Azdle/Tuner/README.markdown

#Freq Tuner
This repo contains some of the source and docs for a frequency tuner project for EE3102.

##Folders
* Prelim Report - Document files for the ungraded preliminary design report.

##TODO
* Setup Others

##Group Members
* Prashant
* Mark Pennebecker
