Azdle/Tuner/Design Report/Analog Subcircuit.pdf

Pre-Amp | Filter | Square Wave Generator
Signal | Microcontroller
