Azdle/Tuner/Design Report/Block Overview.pdf

Analog
Subcircuit | Microcontroller | LED Display Signal
