Azdle/Tuner/Prelim Report/Block Overview.pdf

Pre-Amp | Audio-Range
Filter | Square Wave | Output Buffer
