Azdle/Tuner/pic_code/PIC configuration layout.png

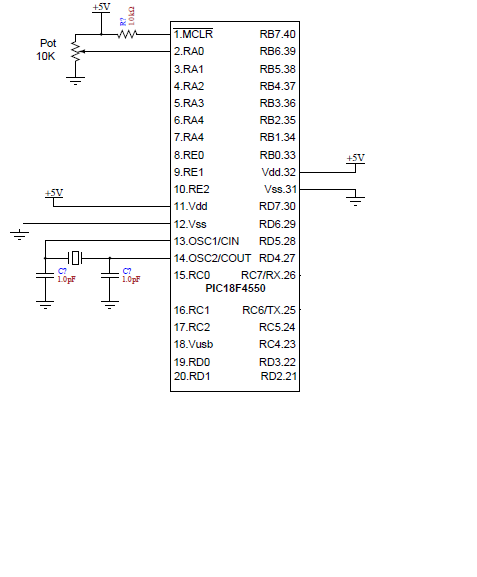
pic_code/PIC configuration layout.png
