Azdle/Tuner/Design Report/filter take 2-SCHEMATIC1-AC.pdf

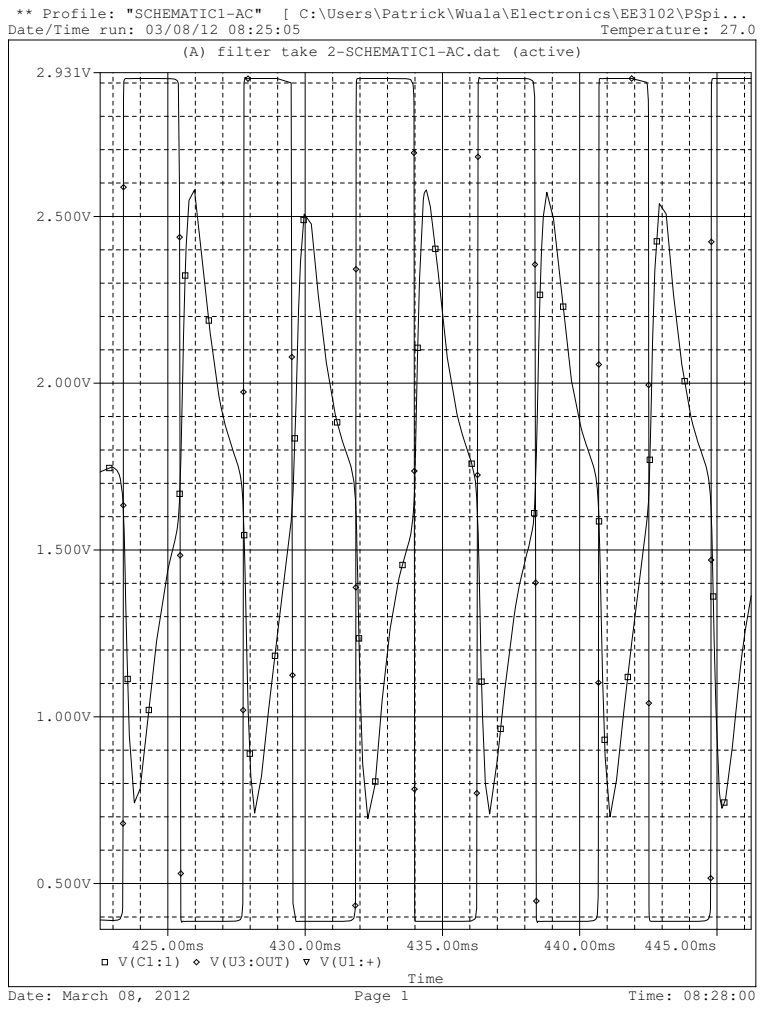
[picture p11: page 1]
** Profile: "SCHEMATIC1-AC"; [ C:\Users\Patrick\Wuala\Electronics\EE3102\PSpi...; Temperature: 27.0; Date: March 08, 2012; Page 1; Time: 08:28:00; Time; V(U3:OUT)

Date/Time run: 03/08/12 08:25:05

(A) filter take 2-SCHEMATIC1-AC.dat (active)
