Azdle/Tuner/Analog Proposal.pdf

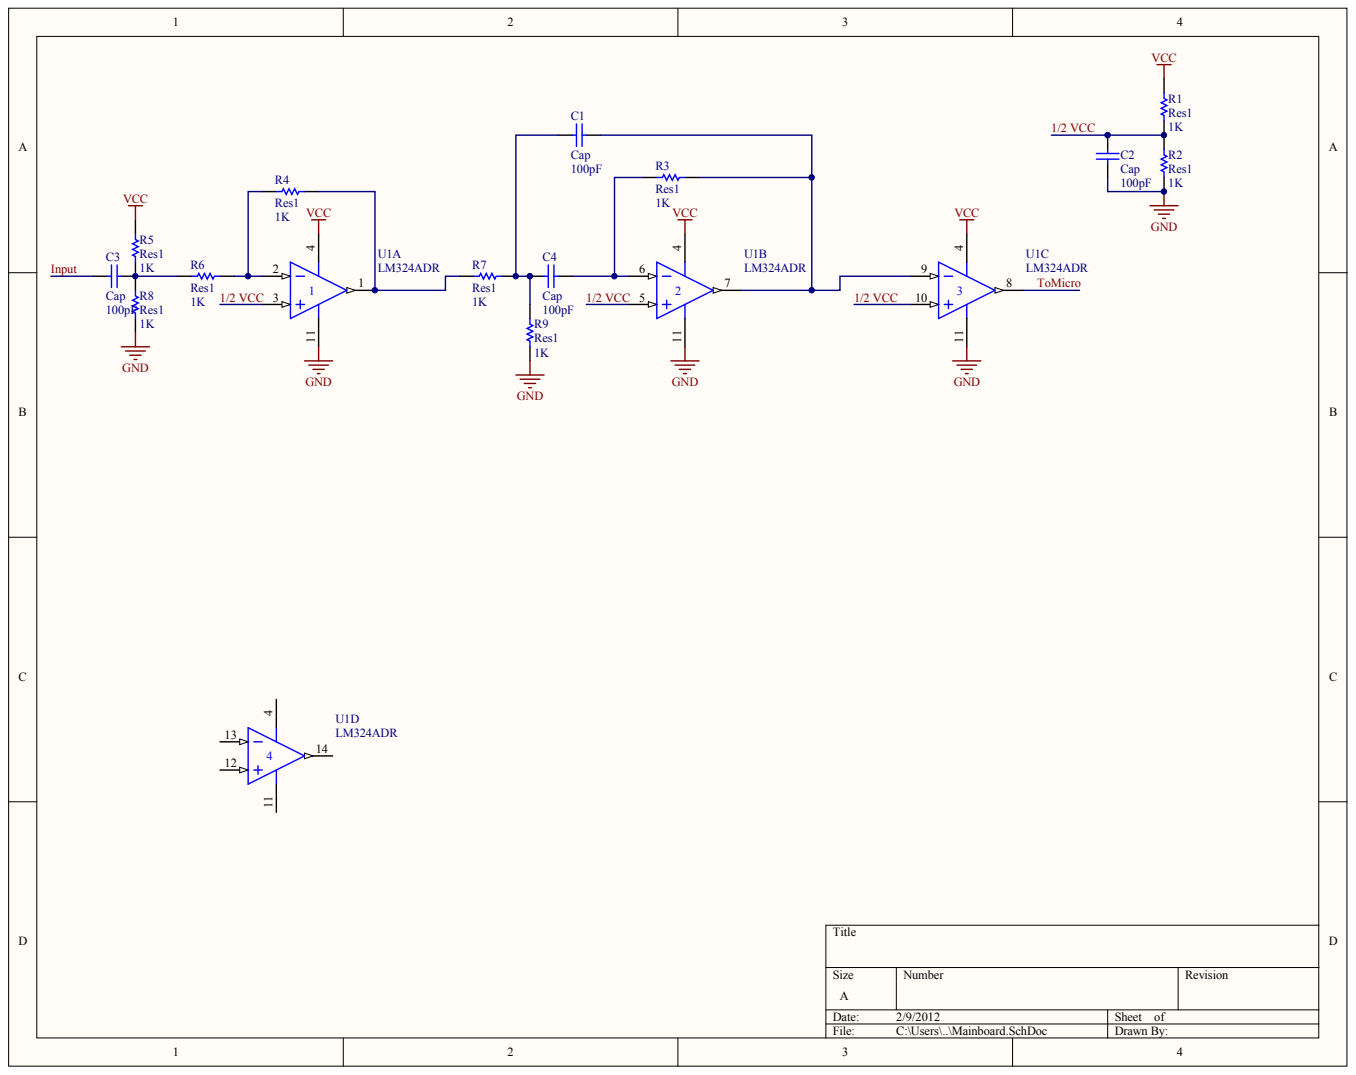
[picture p12: page 1]
