Azdle/Tuner/Design Report/Main Board2.pdf

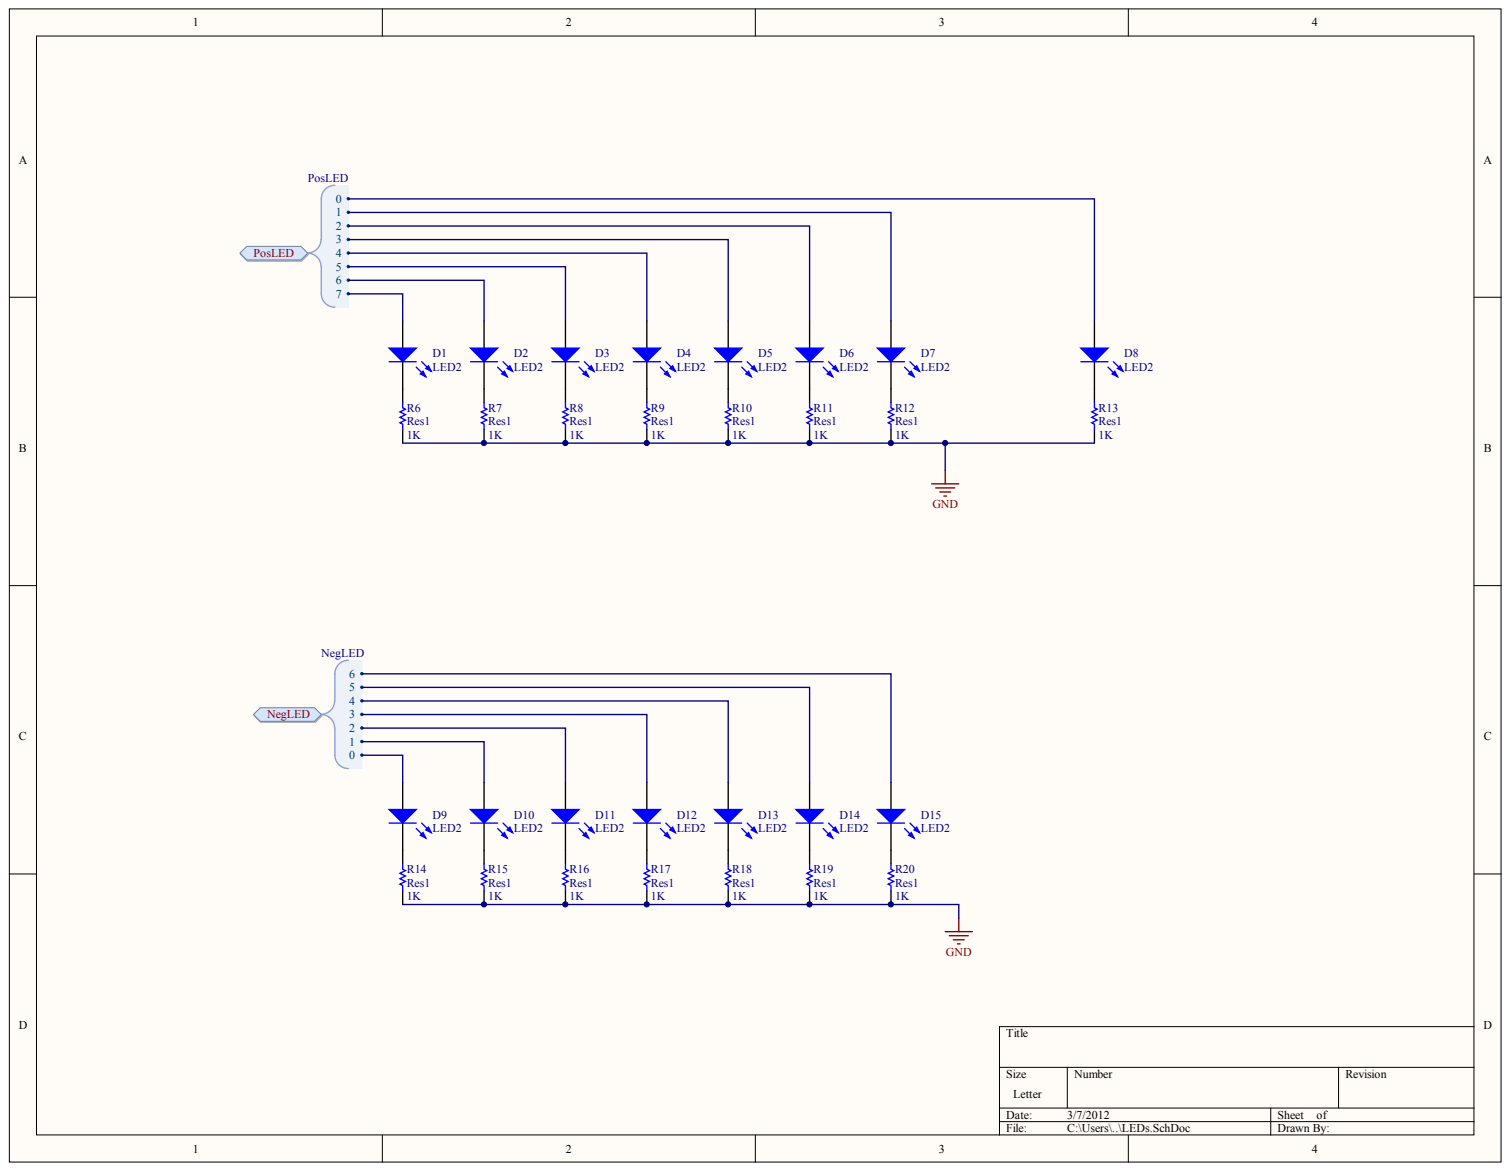
[picture p13: page 3]
