Azdle/Tuner/Main Board.pdf

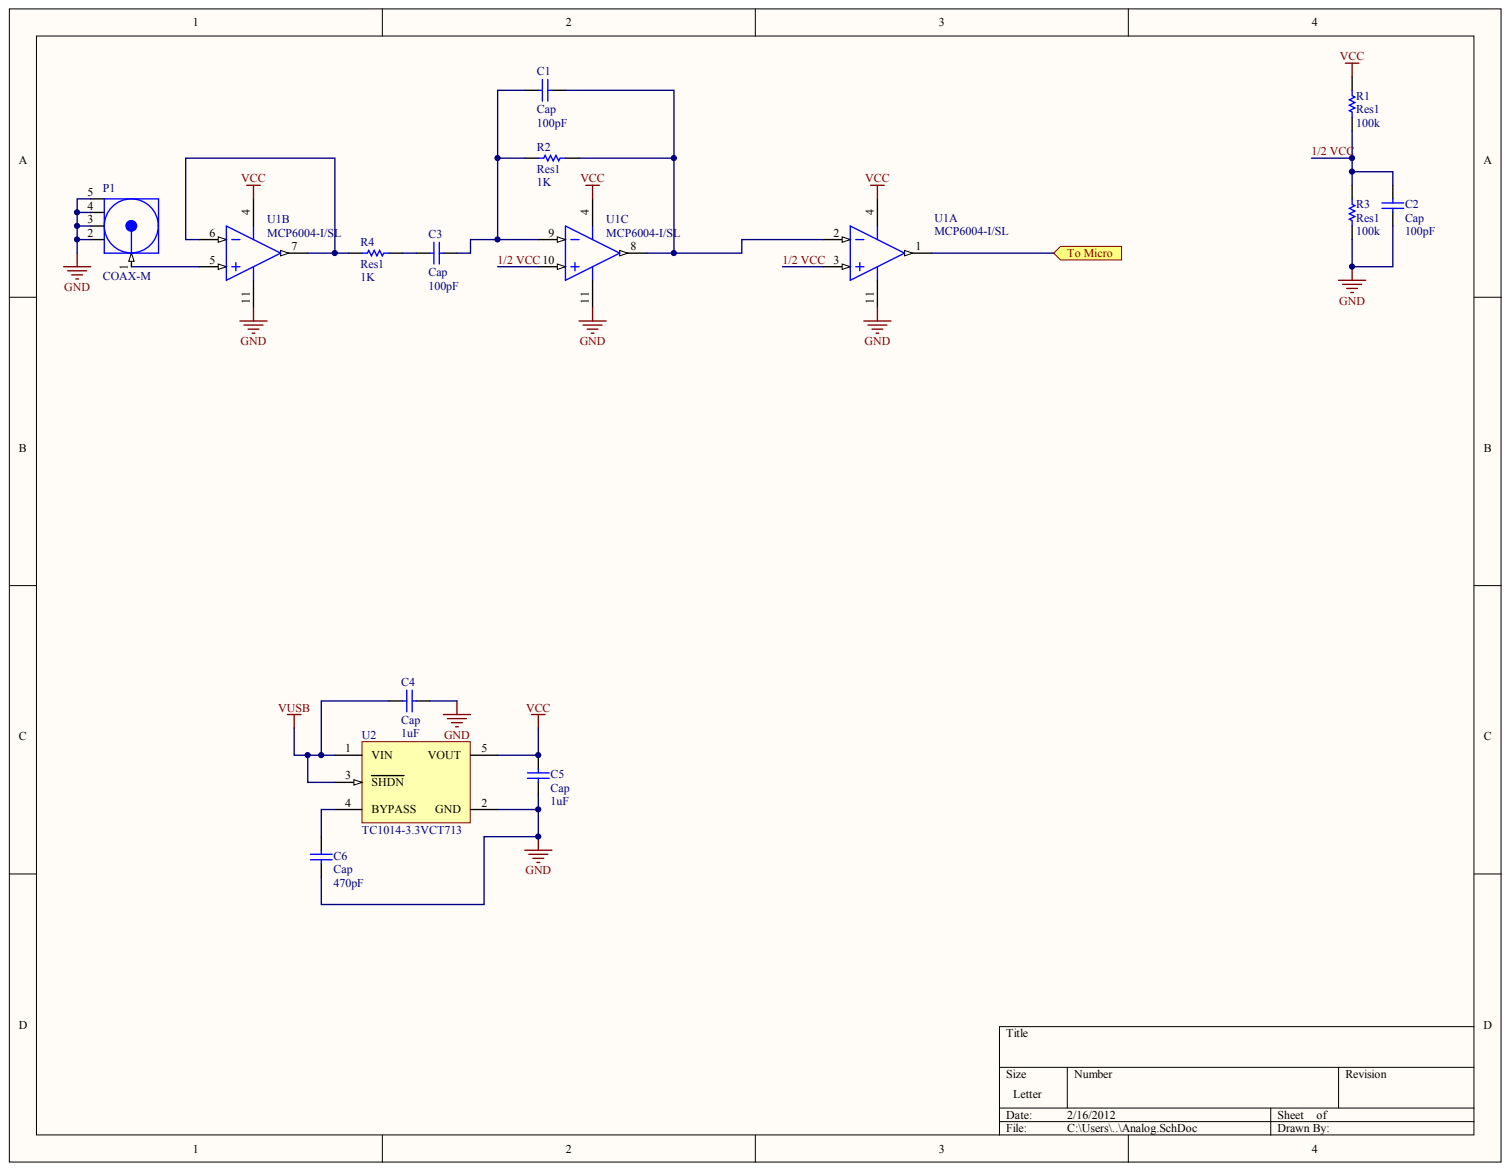
[picture p14: page 1]

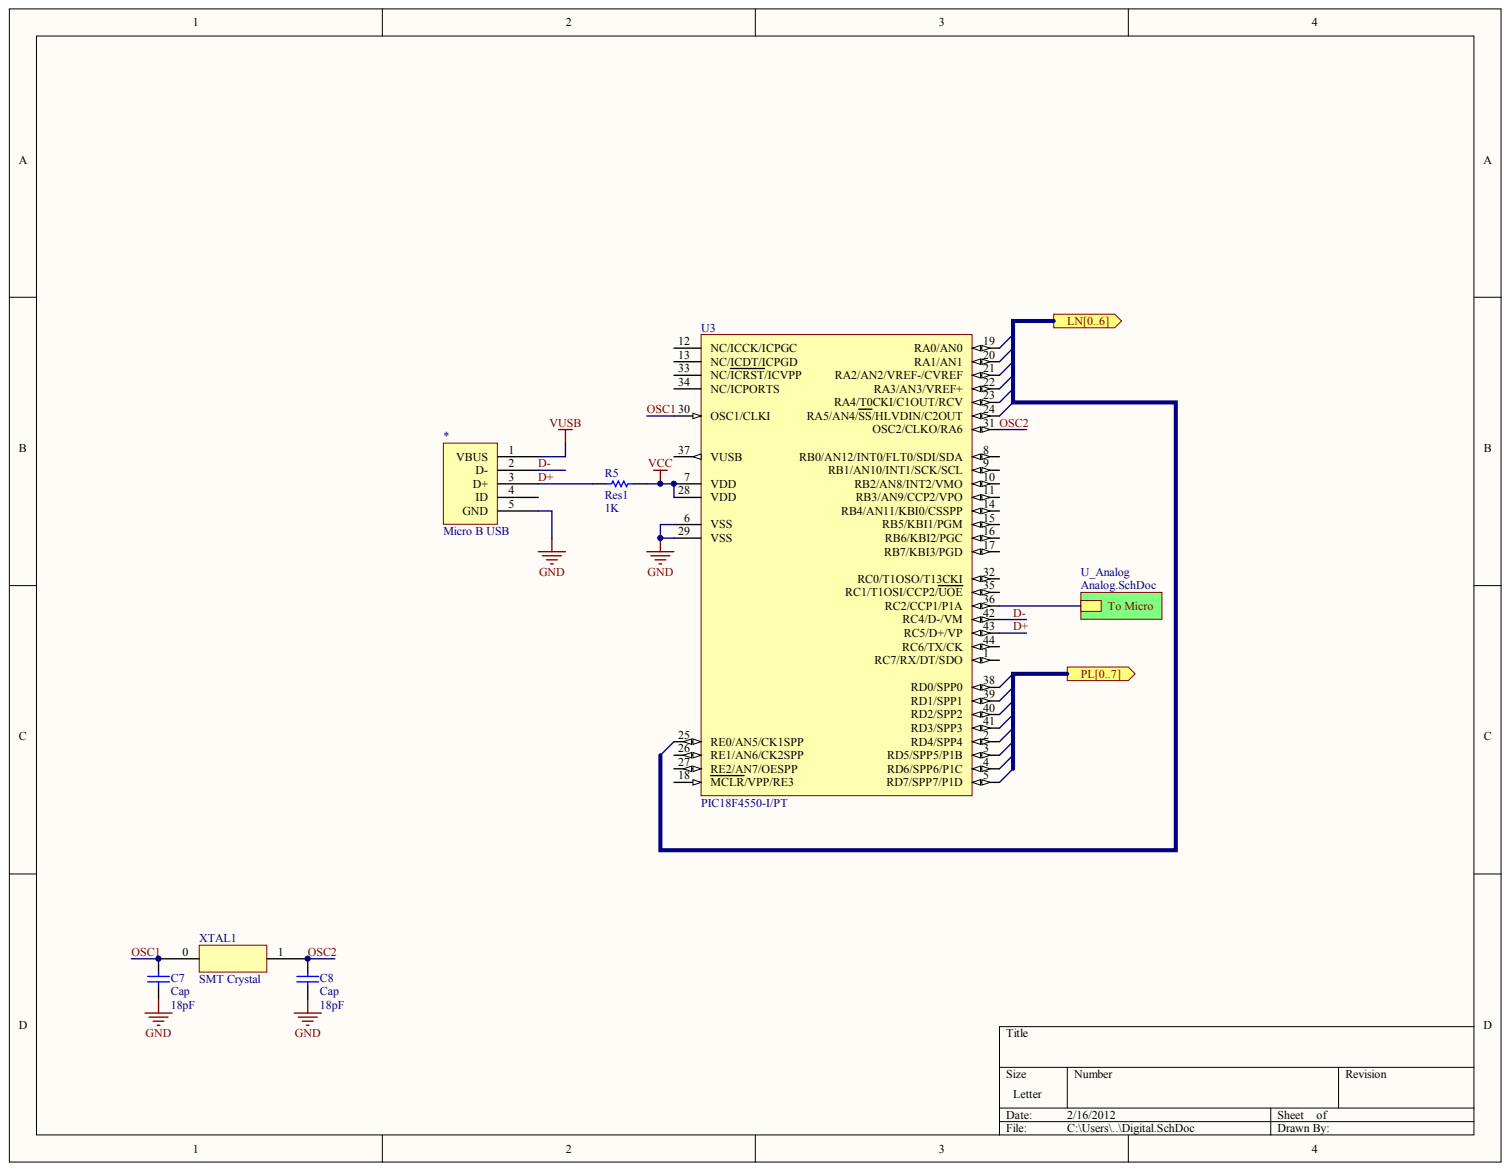
[picture p15: page 2]

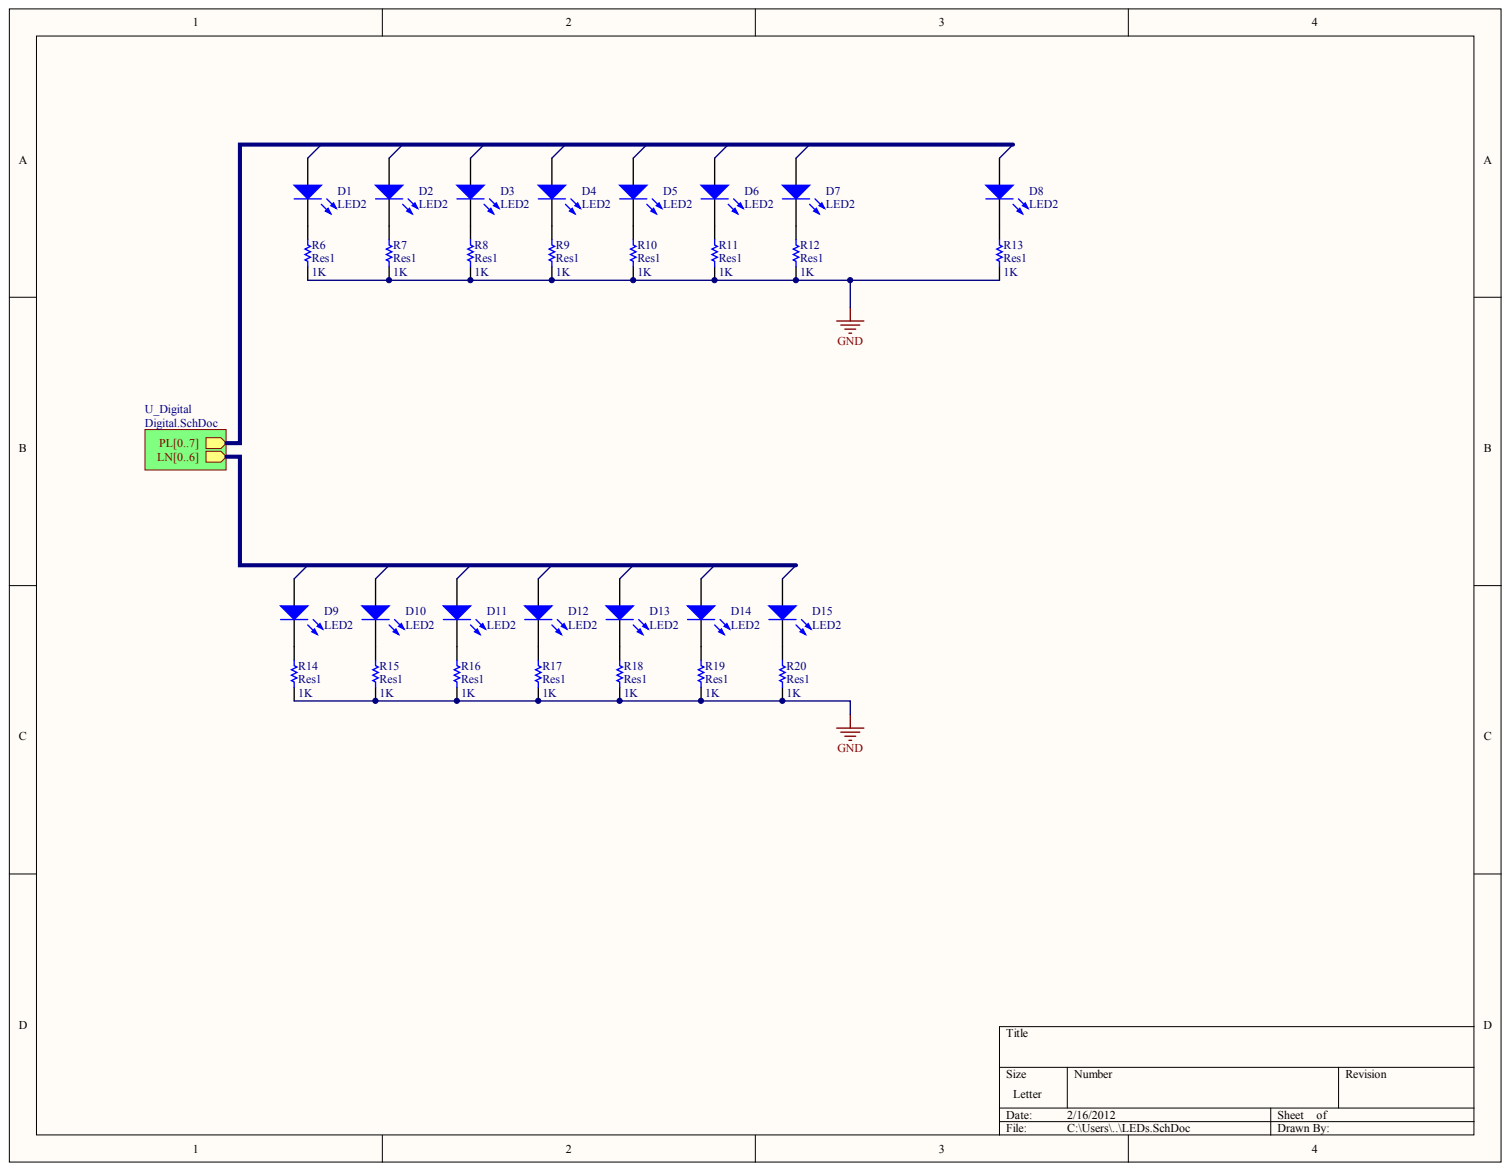
[picture p16: page 3]
