Azdle/Tuner/(list of files, drawings)

Other design files:
PSpice/FILTER TAKE 2.DSN
PSpice/Filter Take 2.opj
