Azdle/Tuner/(commit log)

2012-02-09 Added the sch of filters etc.
2012-02-11 Added PSPICE
    Added a PSPICE simulation for the analog portion
    of the circuit.
    [FILTER TAKE 2.DSN, Filter Take 2.opj]
2012-02-23 fixed a bug in the ISR where it would not function correctly for the first few runs
    [tuner.c]
2012-03-04 updated some of the ISR, Switch Statement configured to correct ports
    [tuner.c]
2012-03-08 PSPICE and Design Report Rough-In
    [FILTER TAKE 2.DSN, Filter Take 2.opj, table.csv]
2012-03-08 Fixed power and Updated PDF
2012-03-08 fixed an issue where the timer1 register was not cleared in interrupts, moved the sleep command to the main loop, updated the cycle counts to run on 16 MHz rather than 48 MHz
    [tuner.c]
2012-03-08 fixed an error in the final design report where 10^6 was 106, also fixed an power formatting error in the description of TMR1
    [tuner.c]
